adafruit/Adafruit-ANO-Rotary-Navigation-Encoder-to-I2C/Adafruit ANO Rotary Encoder to I2C.brd

## EAGLE design Adafruit ANO Rotary Encoder to I2C.brd (2023-05-17)

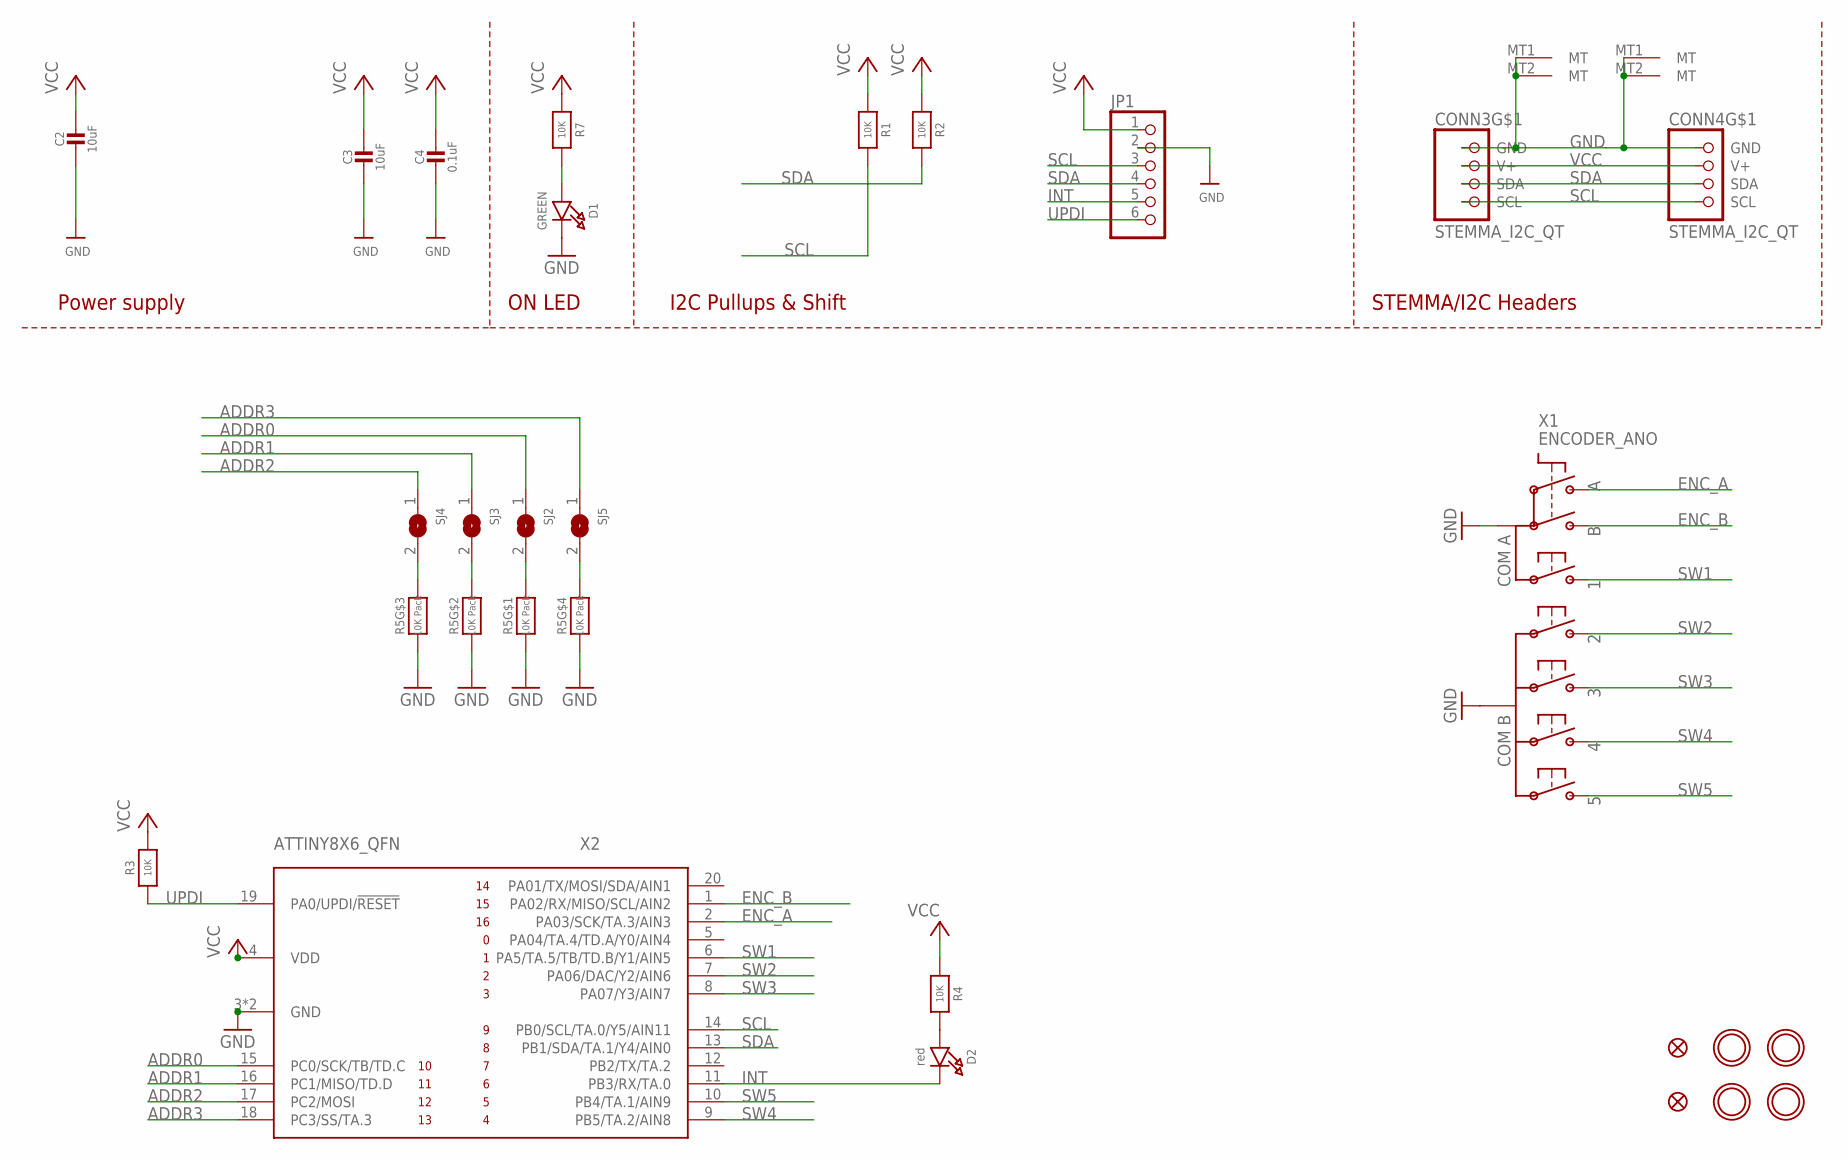
[picture p2: schematic Adafruit ANO Rotary Encoder to I2C.sch]

Parts:
C2, C3: 10uF; 0805-NO
C4: 0.1uF; 0603-NO
CONN3, CONN4: STEMMA_I2C_QT; JST_SH4
D1: GREEN; CHIPLED_0603_NOOUTLINE
D2: red; CHIPLED_0603_NOOUTLINE
FID3, FID4: FIDUCIAL_1MM
JP1: HEADER-1X670MIL; 1X06_ROUND_70
R1, R2, R3, R4, R7: 10K; 0603-NO
R5: 10K Pack; RESPACK_4X0603
SJ2, SJ3, SJ4, SJ5: SOLDERJUMPERCLOSED; SOLDERJUMPER_CLOSEDWIRE
U$25, U$27, U$29, U$30: MOUNTINGHOLE2.5; MOUNTINGHOLE_2.5_PLATED
X1: ENCODER_ANO
X2: ATTINY8X6_QFN; QFN20_3MM

Connections:
ADDR0: SJ2.1, X2.15 (PC0/SCK/TB/TD.C)
ADDR1: SJ3.1, X2.16 (PC1/MISO/TD.D)
ADDR2: SJ4.1, X2.17 (PC2/MOSI)
ADDR3: SJ5.1, X2.18 (PC3/SS/TA.3)
ENC_A: X1.A, X2.2 (PA03/SCK/TA.3/AIN3)
ENC_B: X1.B, X2.1 (PA02/RX/MISO/SCL/AIN2)
GND: C2.2, C3.2, C4.2, CONN3.1 (GND), CONN3.MT1 (MT), CONN3.MT2 (MT), CONN4.1 (GND), CONN4.MT1 (MT), CONN4.MT2 (MT), D1.C, JP1.2, R5.1, R5.2 (1), R5.3 (1), R5.4 (1), X1.COM_A (COMA), X1.COM_B, X2.3 (GND), X2.PAD (GND)
INT: D2.C, JP1.5, X2.11 (PB3/RX/TA.0)
unnamed: D1.A, R7.2
unnamed: D2.A, R4.2
unnamed: R5.8 (2), SJ2.2
unnamed: R5.7 (2), SJ3.2
unnamed: R5.6 (2), SJ4.2
unnamed: R5.5 (2), SJ5.2
SCL: CONN3.4 (SCL), CONN4.4 (SCL), JP1.3, R1.2, X2.14 (PB0/SCL/TA.0/Y5/AIN11)
SDA: CONN3.3 (SDA), CONN4.3 (SDA), JP1.4, R2.2, X2.13 (PB1/SDA/TA.1/Y4/AIN0)
SW1: X1.S1 (1), X2.6 (PA5/TA.5/TB/TD.B/Y1/AIN5)
SW2: X1.S2, X2.7 (PA06/DAC/Y2/AIN6)
SW3: X1.S3, X2.8 (PA07/Y3/AIN7)
SW4: X1.S4, X2.9 (PB5/TA.2/AIN8)
SW5: X1.S5, X2.10 (PB4/TA.1/AIN9)
UPDI: JP1.6, R3.1, X2.19 (PA0/UPDI/!RESET)
VCC: C2.1, C3.1, C4.1, CONN3.2 (V+), CONN4.2 (V+), JP1.1, R1.1, R2.1, R3.2, R4.1, R7.1, X2.4 (VDD)

Notes on the sheet:
I2C Pullups & Shift
STEMMA/I2C Headers
ON LED
Power supply

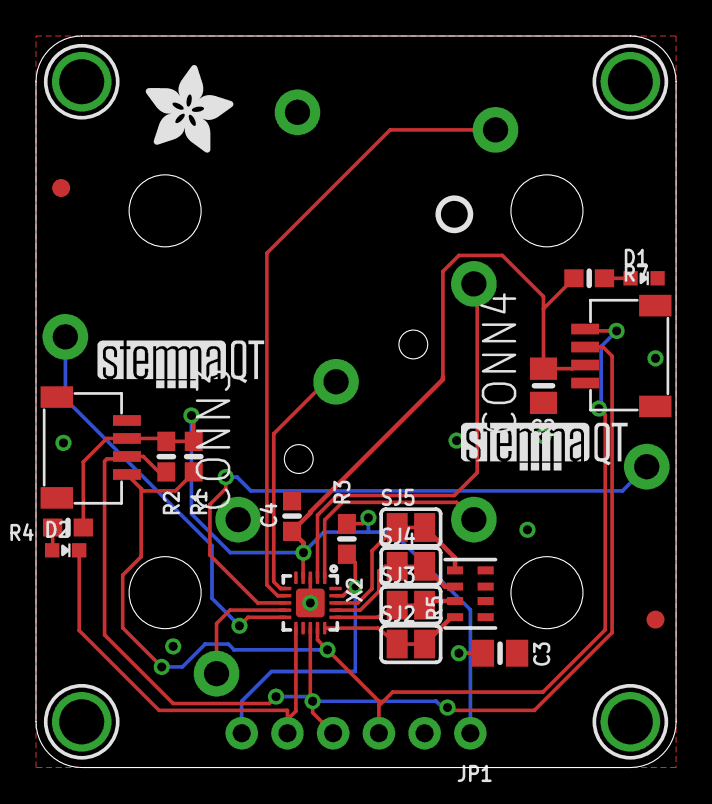
[picture p3: board Adafruit ANO Rotary Encoder to I2C.brd from above]

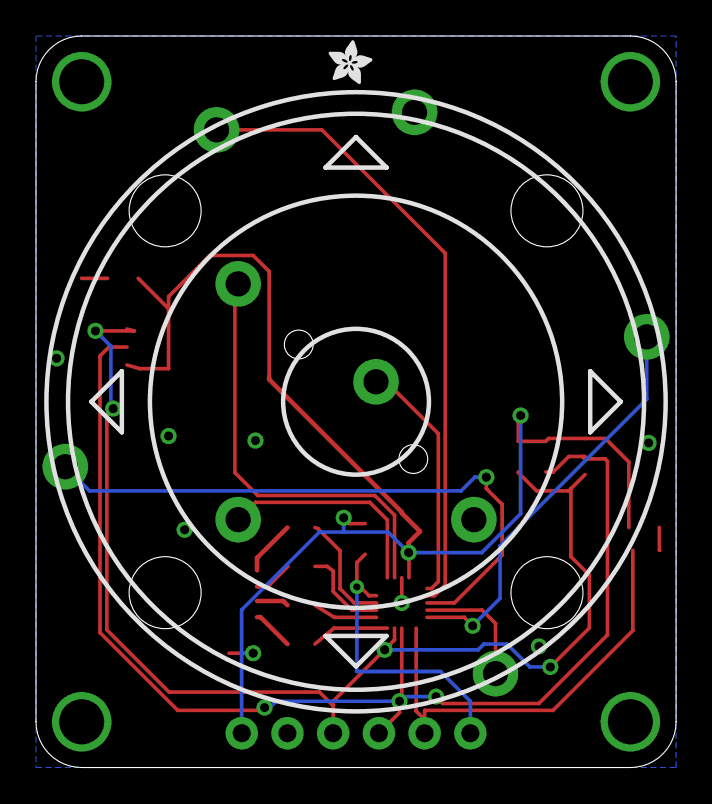
[picture p4: board Adafruit ANO Rotary Encoder to I2C.brd from below]

Board: 2 copper layers, 35.6 x 40.6 mm, 43 parts (2 on the bottom side), 23 nets.

Other parts of the board:
E$2: ADAFRUIT_2.5MM
PLABEL0: PLABEL0
PLABEL1: PLABEL1
PLABEL2: PLABEL2
PLABEL3: PLABEL3
PLABEL4: PLABEL4
PLABEL5: PLABEL5
PLABEL6: PLABEL6
PLABEL7: PLABEL7
PLABEL8: PLABEL8
PLABEL9: PLABEL9
PLABEL10: PLABEL10
PLABEL11: PLABEL11
U$2: ADAFRUIT_5MM
U$33: PCBFEAT-REV-040
U$34, U$35: STEMMAQT
