adafruit/Adafruit-ANO-Rotary-Navigation-Encoder-to-I2C/(threads)

Thread 1 (2025-09-24):

[Request] Round PCB version

FluorescentHallucinogen, 2025-09-24:
I’m thinking about creating a Bluetooth/USB mechanical click wheel in a wristwatch form factor.

I planning to use it to control music playback on my Android smartphone, so that I wouldn’t have to take it out of my pocket, turn it on, and unlock the screen every time I want to go to the next/previous track or rewind/fast-forward the current track.

Since I, as the developer, have full control over the device (for example, via Python), it’s possible to implement support for single, double, long, and simultaneous button presses, as well as multiple layers/layouts/modes that can be switched, e.g., by pressing any two buttons at the same time.

I planning to assign turning the click wheel clockwise (as well as a long press of the right “Next Track” button) to fast-forward the current track, and turning the click wheel counterclockwise (as well as a long press of the left “Previous Track” button) to rewind the current track, just like on the original iPod.

It could also be used as a clicker for switching presentation slides, as a shutter remote button for selfie and group photos, as a TV remote controller for navigating various menus in OS and app UIs, controlling audio and video playback, as well as a simple game controller to play some games, as controller for kids (or adult) toys, and even for mouse emulation and cursor control on PC/Android!

I’ve already built a working prototype using Adafruit ANO Rotary Navigation Encoder to I2C Stemma QT Adapter - Pre-Soldered Encoder (https://adafruit.com/product/6310), Adafruit QT Py ESP32-S3 WiFi Dev Board with STEMMA QT - 8 MB Flash / No PSRAM (https://www.adafruit.com/product/5426), Adafruit LiIon or LiPoly Charger BFF Add-On for QT Py (https://www.adafruit.com/product/5397), and a miniature lithium-ion polymer battery, but in a larger case.

I’m concerned about the device’s size, especially its thickness.

To make this idea a reality, a round version of the PCB is needed.

Ideally, Adafruit ANO Rotary Navigation Encoder to I2C Stemma QT Adapter and Adafruit LiIon or LiPoly Charger BFF Add-On for QT Py should probably be combined into a single PCB.

Here are a few renders of what I have in mind:

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

https://github.com/user-attachments/assets/2df81f5d-84ea-4eb4-b94f-d55fa45f079d
